SEONGBINJEON/Capstone/docs/hardware-notes.md

# 하드웨어 노트

## 모터 배치 (2026-09-28 기준)

| 관절 | 리더 ID / 모델 | 팔로워 ID / 모델 | 비고 |
|---|---|---|---|
| 1 베이스 | 26 XL330-M288 | 11 XL430-W250 | 팔로워는 확장 위치 모드, Homing Offset 1024 |
| 2 어깨 | 27 XL330-M288 | 12 XM430-W210 | |
| 3 팔꿈치 | 28 XL330-M288 | 13 XL430-W250 | |
| 4 손목 | 29 XL330-M288 | 14 XL430-W250 | |
| 그리퍼 | 30 XC430-W150 | 15 XC430-W150 | 리더 30은 4.5 V 전원 → 전압 경고 비트 상시 ON |

- 리더 보드 OpenRB-150, 팔로워 보드 OpenCR. 통신 1 Mbps, Protocol 2.0.
- 링크 길이 180 / 130 / 100 mm. Fin-Ray 그리퍼 TPU 95A, 랙·피니언 개폐.

## 모터 영구 설정(EEPROM) 변경 이력

| 날짜 | 모터 | 항목 | 이전 → 이후 | 이유 |
|---|---|---|---|---|
| 2026-09-13 | 11 | Operating Mode / Homing Offset | 3 → 4(확장 위치), 0 → 1024 | 베이스 0/4095 경계 통과 (이전 세션) |
| 2026-09-28 | 13 | Min/Max Position Limit | 1024/3140 → 0/4095 | 접힌 자세(~600)가 범위 밖. 백업 `teleoperation/work/eeprom_limit_backup_13_*.json` |

## 소프트웨어 설정(`sim_teleop/config.json`) 주요 값

- 리더 기준점(일자 자세): 26 = 2060, 27 = 2036, 28 = 2047, 29 = 2051
- 팔로워 기준점: 11 = 2048(논리, 원시 1060), 12 = 2334, 13 = 1995, 14 = 2064
- 그리퍼: 리더 닫힘 160 / 열림 1625(추정), 팔로워 닫힘 916 / 열림 2279
- 안전: 정렬 15°/s, 추종 180°/s, 추종 오차 20°, 걸림 1.4 s, 온도 60 °C, watchdog 300 ms

## 알려진 주의점

- 팔로워 3번은 리더 목표가 약 456 tick 부근으로 갈 때 기구 한계에 걸림 → 과부하(0x20) 가능. 걸림 보호가 있지만 리더 쪽 범위 제한이 근본 해결.
- 베이스 ±179° 허용으로 넓혔으나 케이블 감김은 미확인.
