SEONGBINJEON/Capstone/media/renders/02_isaac_kitchen_current_pose.png

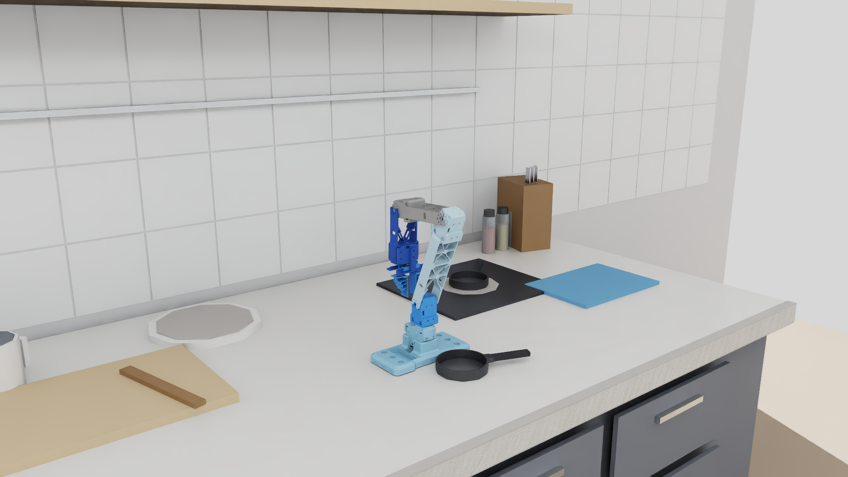
media/renders/02_isaac_kitchen_current_pose.png
