SEONGBINJEON/Capstone/media/renders/04_parallel_arms_100_low_angle.png

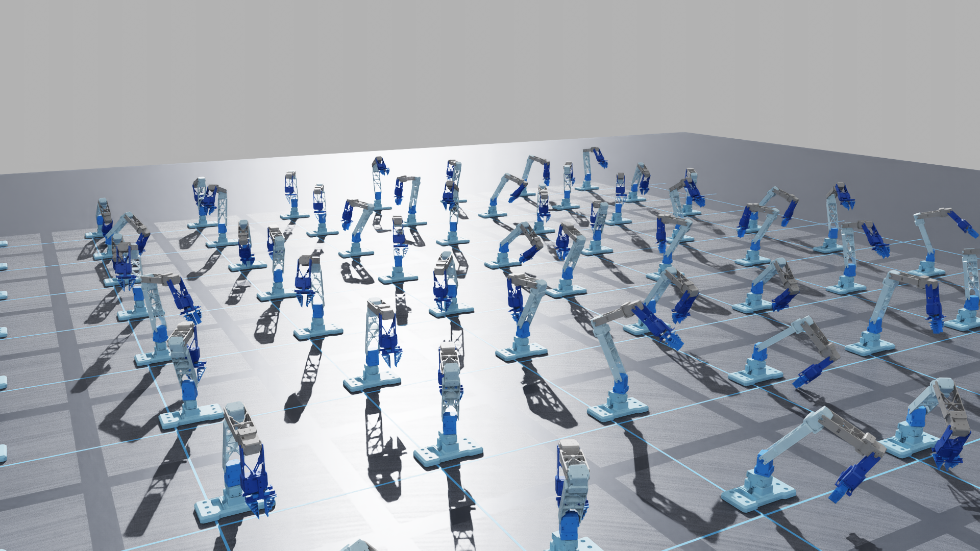
media/renders/04_parallel_arms_100_low_angle.png
