SEONGBINJEON/Capstone/media/renders/05_parallel_kitchens_3x3.png

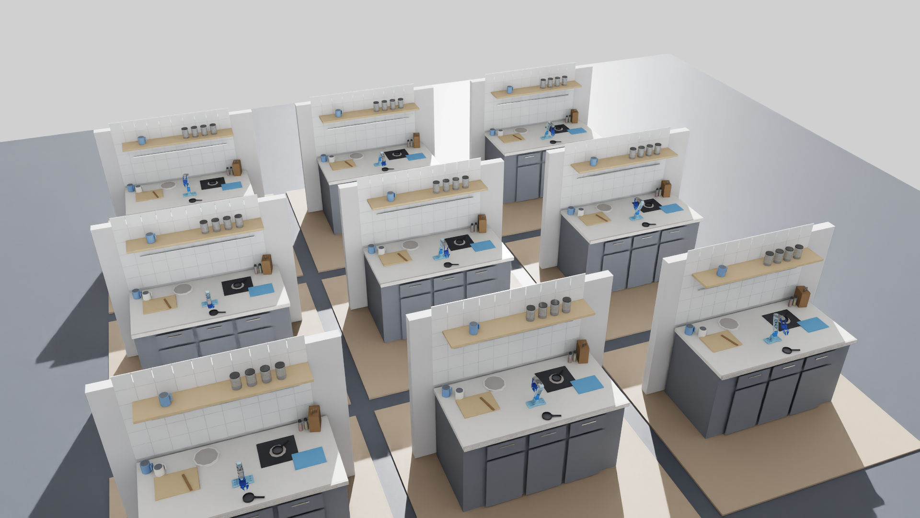
media/renders/05_parallel_kitchens_3x3.png
