SEONGBINJEON/Capstone/media/renders/06_parallel_kitchens_3x3_low_angle.png

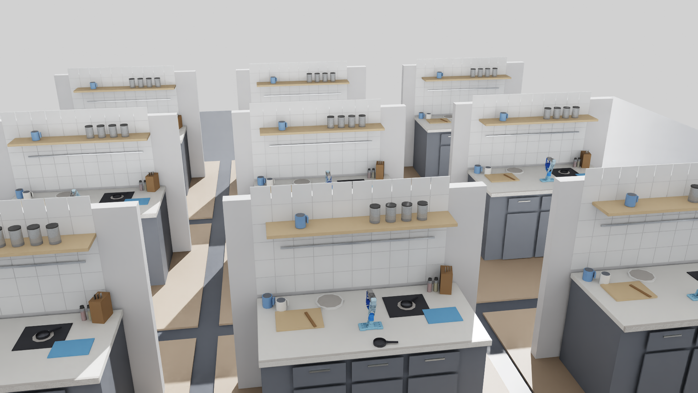
media/renders/06_parallel_kitchens_3x3_low_angle.png
