SEONGBINJEON/Capstone/media/renders/07_hero_demo_pose.png

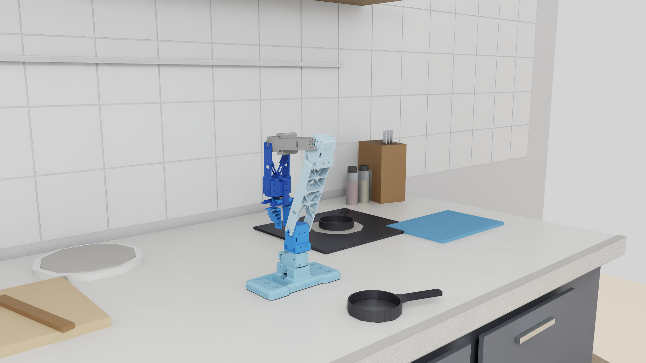
media/renders/07_hero_demo_pose.png
