SEONGBINJEON/Capstone/media/renders/08_hero_hover_pose.png

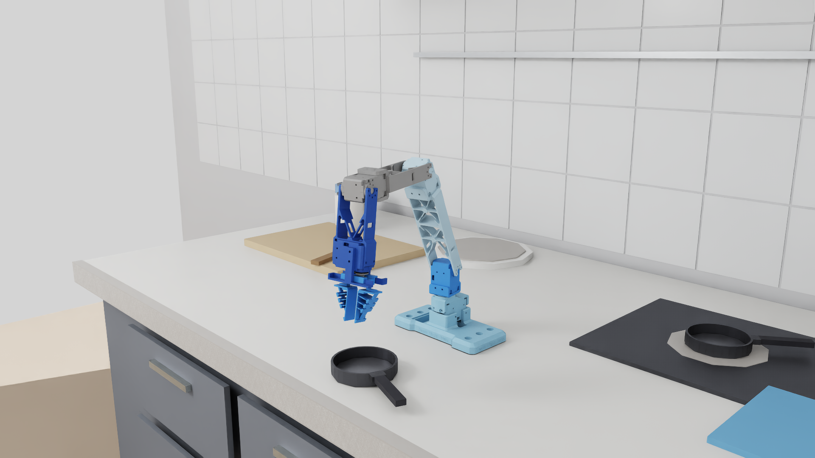
media/renders/08_hero_hover_pose.png
