SEONGBINJEON/Capstone/media/renders/09_gripper_closeup_pan.png

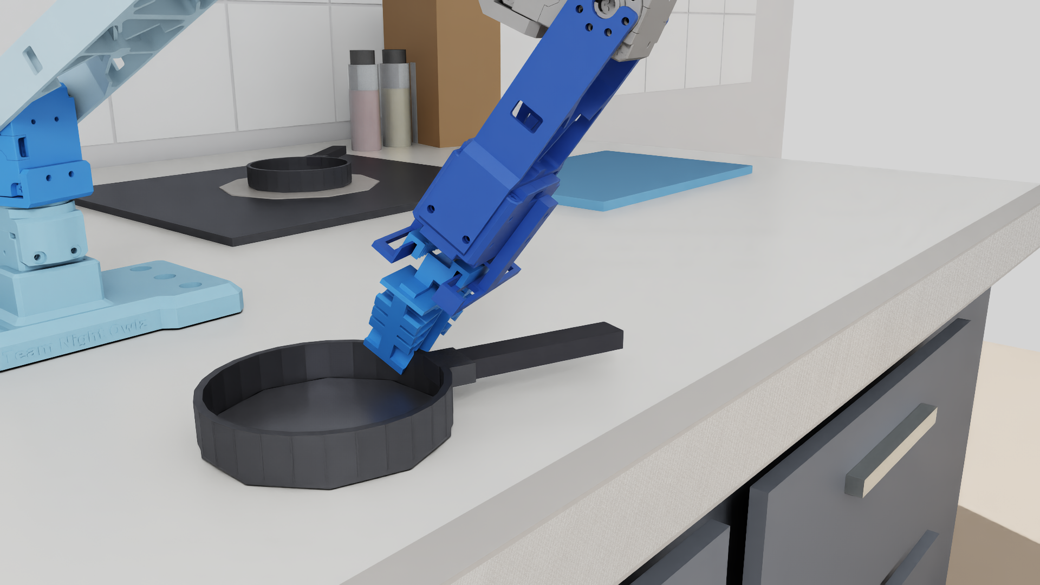
media/renders/09_gripper_closeup_pan.png
