SEONGBINJEON/Capstone/media/renders/14_top_view_workspace.png

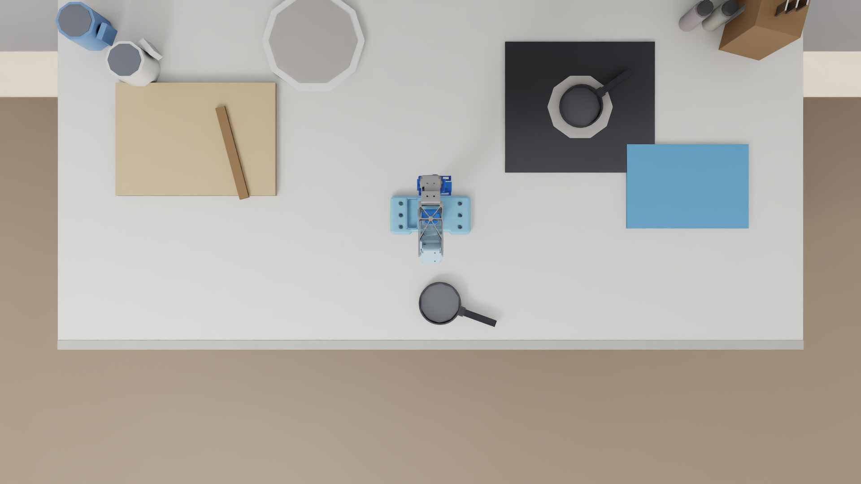
media/renders/14_top_view_workspace.png
