SEONGBINJEON/Capstone/isaac_sim/robot_model/assets/follower_05.stl

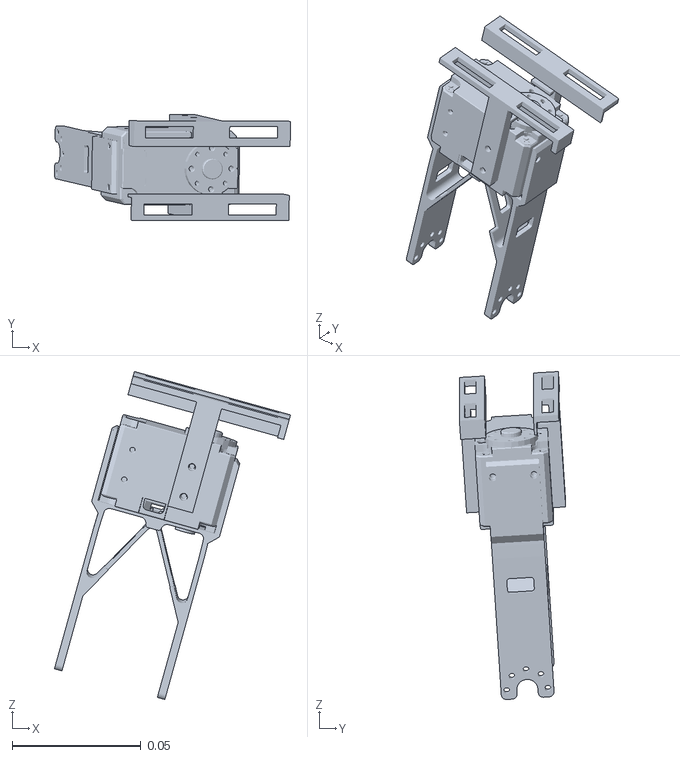
[picture p15: CAD file, 2026-09-29]
isaac_sim/robot_model/assets/follower_05.stl
0.0917 x 0.0412 x 0.127
