SEONGBINJEON/Capstone/isaac_sim/robot_model/assets/follower_04.stl

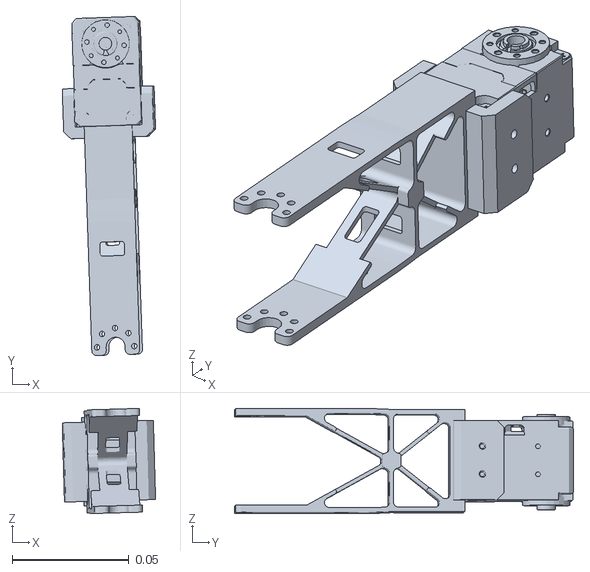
[picture p16: CAD file, 2026-09-29]
isaac_sim/robot_model/assets/follower_04.stl
0.04 x 0.145 x 0.0451
