SEONGBINJEON/Capstone/isaac_sim/robot_model/assets/follower_03.stl

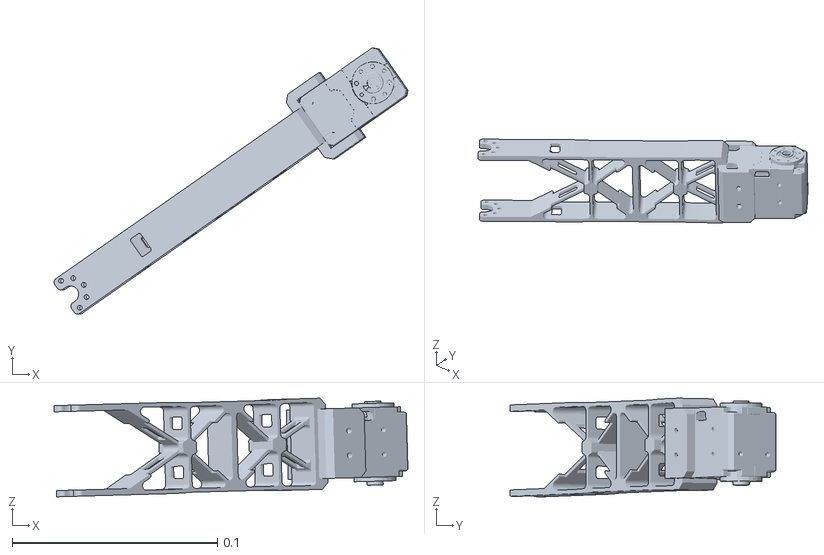
[picture p17: CAD file, 2026-09-29]
isaac_sim/robot_model/assets/follower_03.stl
0.173 x 0.13 x 0.0481
