SEONGBINJEON/Capstone/isaac_sim/robot_model/assets/follower_01.stl

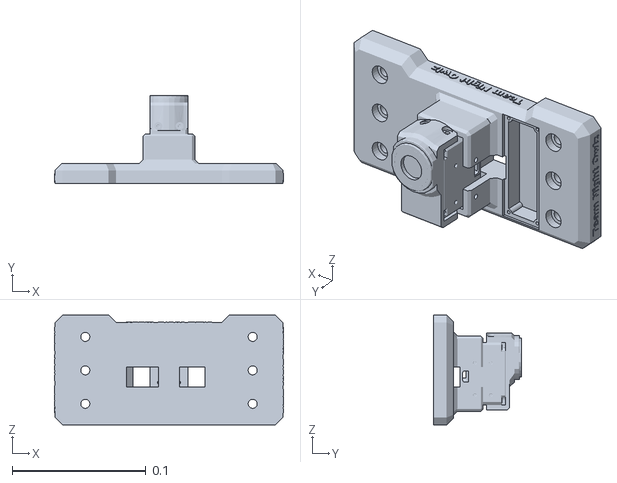
[picture p18: CAD file, 2026-09-29]
isaac_sim/robot_model/assets/follower_01.stl
0.171 x 0.066 x 0.082
