SEONGBINJEON/Capstone/isaac_sim/robot_model/assets/follower_06.stl

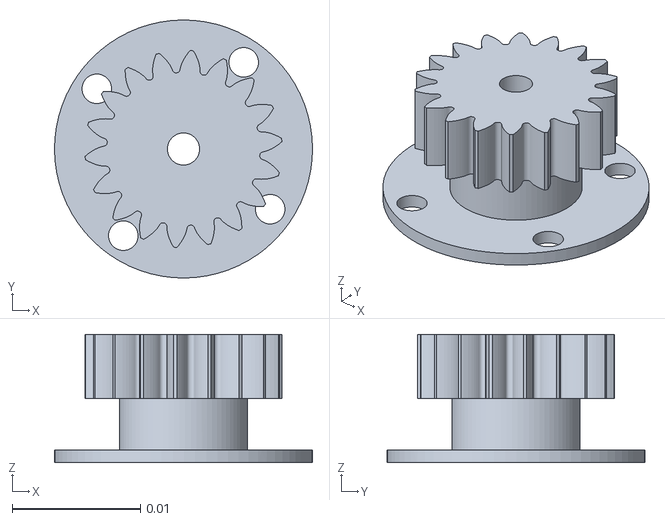
[picture p19: CAD file, 2026-09-29]
isaac_sim/robot_model/assets/follower_06.stl
0.0201 x 0.0201 x 0.01
