SEONGBINJEON/Capstone/isaac_sim/robot_model/assets/follower_07.stl

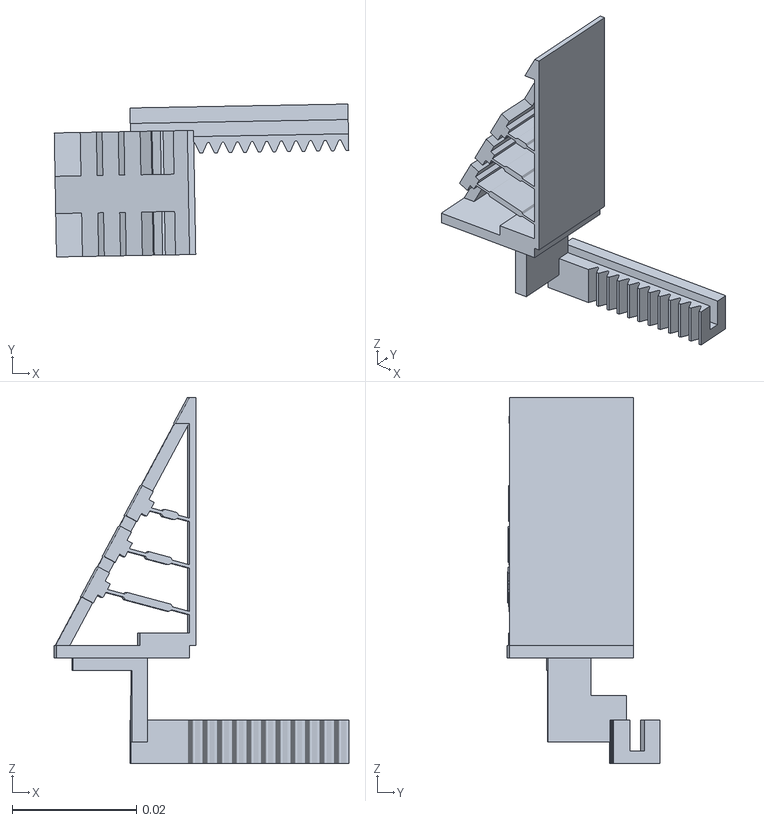
[picture p20: CAD file, 2026-09-29]
isaac_sim/robot_model/assets/follower_07.stl
0.0475 x 0.0247 x 0.059
