SEONGBINJEON/Capstone/isaac_sim/robot_model/assets/follower_02.stl

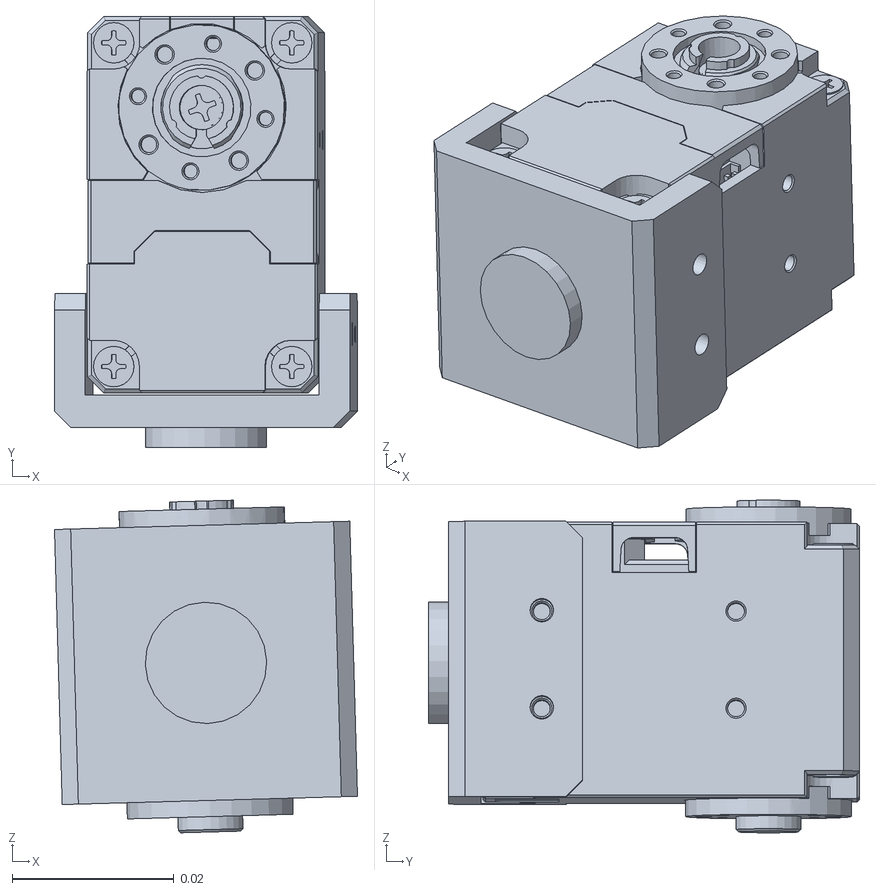
[picture p21: CAD file, 2026-09-29]
isaac_sim/robot_model/assets/follower_02.stl
0.0374 x 0.0532 x 0.0411
