SEONGBINJEON/Capstone/teleoperation/docs/calibration_B.md

# B 보정 기록 — 2026-09-13

사용자가 리더/팔로워 B를 모두 일자로 세워 위를 향하도록 받친 상태에서 5개 연속 샘플로 저장했습니다. 같은 모터 축 방향과 링크 전달 비율에 근거해 direction=+1, scale=1입니다.

| 대응 | 리더 기준 | 팔로워 기준 |
|---|---:|---:|
|26 → 21|12|2048 (원시 기준 4080)|
|27 → 22|2036|2052|
|28 → 23|2047|2042|
|29 → 24|2051|2061|

21번은 토크 OFF 상태에서 모드 3 → 4로 변경했습니다. 원점을 움직이는 구동은 하지 않았습니다. 저장된 원시 4080을 논리 2048로 환산하며 초기 턴 오프셋은 세션 중 고정합니다. Homing Offset은 0입니다. 새 세션에서도 동일 기준을 사용합니다.

기록: `work/B_upright_closed_capture.json`, 변경 전 백업: `work/backups/B_base_before_extended.json`.

그리퍼 30/25번은 사용자 요청으로 제외했습니다. 닫힘만 160/2086으로 기록되어 있고 열림은 보정하지 않았습니다. `enabled=false` 상태에서 읽기/쓰기 대상에서도 제외합니다.

실제 기구 전체 범위가 검증되었다는 표시(reviewed)는 넣지 않았습니다. 모터 범위 정책으로 직접 관절 대응을 사용합니다.
