SEONGBINJEON/Capstone/(commit log)

2026-09-29 텔레오퍼레이션 재구축, Isaac Sim 디지털 트윈, 발표용 렌더 (2026-09-28)
    - teleoperation/sim_teleop: 리더 26~30 → 팔로워 11~15 실시간 추종(그리퍼 포함), UDP 발행,
    걸림·과부하 보호, 보정/재부팅 도구
    - isaac_sim/robot_model: 메시 경로를 고친 robot_isaac.urdf와 변환 USD
    - media/renders: Isaac Sim 렌더 14장과 발표자료 제작 프롬프트
    - docs: 진행 기록, 하드웨어 노트(EEPROM 변경 이력 포함)
    [end_of_day_motor_state.json, follower_01.stl, follower_02.stl, follower_03.stl, follower_04.stl, follower_05.stl, follower_06.stl, follower_07.stl]
2026-09-29 다른 PC 이식성: 로봇 USD 경로를 저장소 기준으로 해석, 시작 절차 문서화
2026-09-29 학습 가이드 추가 (docs/study): 구조, DYNAMIXEL 제어, 추종 루프, Isaac Sim, 디버깅 기록, 면접 노트
2026-09-29 정리: USD 백업 파일 삭제, 옛 A/B 안내문에 이전 세대 표시, 도구 스크립트 문서화
    - payloads/*.usda.bak 제거 (재질 수정 전 백업, 불필요)
    - teleoperation/README.md, START_HERE.md 맨 위에 2026-09-13 다른 PC 기록임을 명시하고 현재 문서로 연결
    - sim_teleop/README.md: 로컬 경로를 저장소 기준으로, 도구 스크립트 7개 설명 추가
    - _fake_loop_test.py → offline_loop_test.py
    [offline_loop_test.py]
2026-10-13 docs: README를 포트폴리오용으로 정리
    - 첫 화면: 프로젝트 한 줄 소개, 대표 렌더, 출품 대회와 팀
    - 한눈에 보기: 문제, 설계, 텔레오퍼레이션, 안전 설계, 디지털 트윈, 검증 범위
    - 시스템 구성도(mermaid), 렌더 갤러리(연출 장면임을 명시)
    - 문제 해결 대표 사례 4건, 생산기술 관점 대응표, 기술 스택, 팀 역할
    - 기존 저장소 구조와 실행 방법은 그대로 유지
2026-10-13 docs: README에서 관련 없는 KOVA 대회 내용 제거, 저장소 자료 기준으로 수정
    - KOVA 대회명, 팀명, 작업반경, 시연 작업 수 등 외부 자료에서 온 문장 삭제
    - 목표·하드웨어·현재 단계를 기존 README, 진행 기록, 발표 프롬프트 기준으로 다시 작성
2026-10-13 docs: 대회명 표기 삭제 (README, 발표 프롬프트)
2026-10-13 docs: README 한 줄 소개를 소개 칸과 같은 표현으로 수정
